DansProjects-24/ArduGauge/README.md

# ArduGauge
This is my Arduino Based Automotive Gauge project, Ardugauge.
Here you'll find any CAD, code, and documentation for the project.  

See more on my website: https://daniel-barker.com/project-browser/ardugauge.html
