DansProjects-24/ArduGauge/Documentation/ArduGauge V1 BOM.xlsx

Sheet: M-Bom
 | Component | Ref | Qty per Assy | Unit Price | Total Price | Print Time [hh:mm]
3D Printed Part | ArduGauge Housing |  | 1 | £0.37 | £0.37 | 1:36:00
 | Spacer Piece |  | 1 | £0.11 | £0.11 | 0:30:00
 | RetainingCollar |  | 1 | £0.31 | £0.31 | 1:20:00
 | RetainingPlate |  | 1 | £0.08 | £0.09 | 0:26:00
Purchased | M2x10 HEX PCB Spacers |  | 8 | £0.44 | £3.52
 | M2x5 Pozi Pan Head Screw |  | 4 | £0.34 | £1.36
 |  |  |  |  | £5.76 | 3:49:00
 | *3D Printed cost & ime includes any waste support material and rafts

Sheet: E-Bom
Component | Ref Name | Value | Package | RS Part Number | Qty | Unit Cost | Notes | Description
ArduGauge V1 PCB |  | - | - | N/A | 1 | £4.990 |  | Manufactured by Aisler. Min order qty 3
1.28" Round LCD |  |  |  | N/A | 1
Multilayer Ceramic Capacitor - 0603 22pF | C1, C2 | 22pF | 0603 (1608) | 8882790 | 2 |  |  | AVX 0603 22pF Ceramic Multilayer Capacitor, 100 V dc, +125C, C0G, NP0 Dielectric, 10%
330μF Electrolytic Capacitor 16V dc, Surface Mount | C3 | 330uF | SMD | 747-2506 | 1 | £0.893 |  | Panasonic 330μF Electrolytic Capacitor 16V dc, Surface Mount - EEEFTC331XAP
 | C4 | 10uF |  |  | 1
100nFMultilayer Ceramic Capacitor 16V, SMD, 0603 (1608M) | C5 | 100nF | 0603 (1608) | 264-4630 | 1 | £0.073 |  | TDK 100nF Multilayer Ceramic Capacitor MLCC 50 V dc 20% X7R Dielectric 1608 Solder Max. Op. Temp. +125C
47μF Electrolytic Tantalum Capacitor 6.3V dc | C6 | 47uF | 3528-21 | 136-6107 | 1 | £0.643 |  | AVX 47μF Electrolytic Tantalum Capacitor 6.3V dc, TPS Series
 | C7, C8 | 10nF |  |  | 2
Inductor 10uH Wire-Wound 1.3A Idc | L1 | 10uH |  | 741-9145 | 1 | £0.590 |  | RS Pro NPIS53D Series Shielded Wire-wound SMD Inductor 10 uH +/-20% Wire-Wound 1.3A Idc
ATMEGA328P-AU, SMD TQFP-32 | IC1 |  | TQFP-32 | 1310271 | 1 | £2.754 |  | MICROCHIP - ATMEGA328P-AU. - MICROCONTROLLER MCU, 8 BIT, ATMEGA, 20MHZ, TQFP-32
JST, PH, 8 Way, 1 Row, Right Angle PCB Header | J1 |  | 8-Pin | 688-1372 | 1 | £1.303 |  | Conn Shrouded Header (4 Sides) HDR 8 POS 2mm Solder RA Side Entry SMD T/R
JST, PH, 8 Way, 1 Row, Straight PCB Header | J2, J3 |  | 8-Pin | 688-1347 | 2 | £1.406 |  | PH SMT top entry shrouded header 8 way JST PH Series, 2mm Pitch 8 Way 1 Row Straight PCB Header, Solder Termination, 2A
CONN_SIL_5 | PL1 | 5-SIL | 5-SIL | - | 1 | £0.500 |  | 5 way Pin Header. 2,54mm Pitch, through hole.
10kΩ, 0805 (2012M) Thick Film SMD Resistor | R1, R9-11 | 10K | 0805 (2012) | - | 4 | £0.300 | *** | 10kΩ, 0805 (2012M) Thick Film SMD Resistor
Vishay 4.7kΩ, 0805 (2012M) Thick Film SMD Resistor ±1% 0.5W | R2, R3 | 4K7 | 0805 (2012) | 812-3574 | 2 | £0.211 | *
5V Low Dropout Voltage Regulator, 1.3A | IC2 | 5V | SOT-223 | 686-9381 | 1 | £0.575 |  | LD1117S50CTR, Low Dropout Voltage Regulator, 1.3A, 5 V 1%, 4-Pin SOT-223
16MHz SMD Crystal, 20ppm, 2-Pin HC-49/U-S SMD | Y1 | 16MHz | 2-Pin SMD | 1734749 | 1 | £0.470 |  | 16.000MHz QCS HC49/U-S SMD Crystal 16MHz, 20ppm, 2-Pin HC-49/U-S SMD
RESISTOR THT | R5-8 | Varies | DISC03 | - | 4 | £0.150 | **
Tactile Switch, (SPST) 50 mA @ 12 V dc 1.5mm Surface Mount | S1 | SPST | SMD | 758-2063 | 1 | £0.742 |  | Tact switch,SMT,SPST,with stem,3.43N o/f Stem Tactile Switch, SPST-NO 50 mA 1.5mm
JST, PH, 8 Way, 1 Row, Cable Mount Connector | - | 8-Way | 8-Pin | 820-1488 | 3 | £0.214
Totals |  |  |  |  |  | £19.209
 |  |  |  |  |  |  | * | Only required when I2C bus is used
 |  |  |  |  |  |  | ** | User selectable. 1 Required per analog channel
 |  |  |  |  |  |  | *** | R9 - 11 only required for V supply monitoring
 |  |  |  |  |  |  |  | Indicative pricing. This may be due to ordering unbranded components or obsolecence of old stock.
