DansProjects-24/ArduGauge/CAD/ArduGauge_Bezel_B.STL

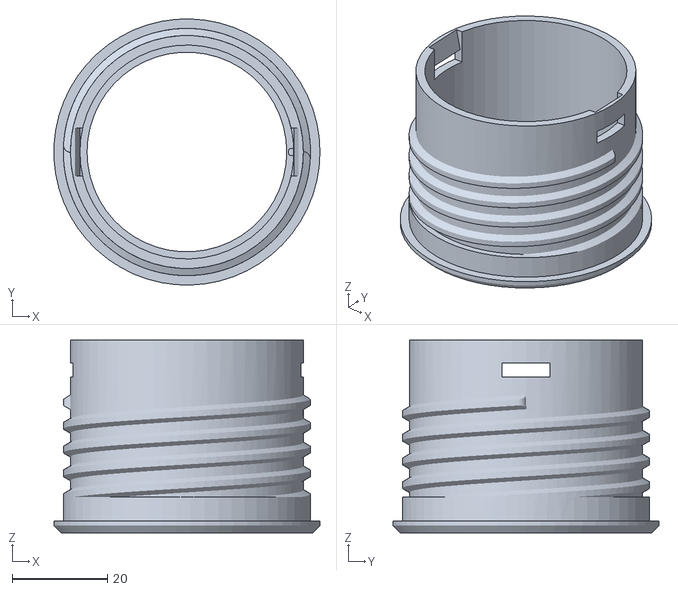
[picture p1: CAD file, 2024-09-01]
CAD/ArduGauge_Bezel_B.STL
56.0 x 56.0 x 40.5
