DansProjects-24/ArduGauge/CAD/RetainingPlate_B.STL

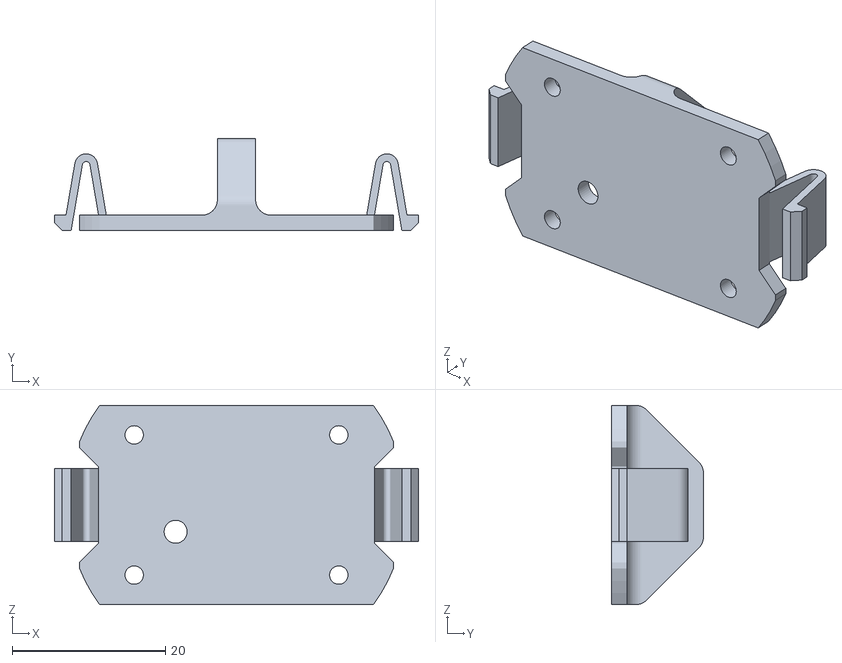
[picture p2: CAD file, 2024-09-01]
CAD/RetainingPlate_B.STL
47.5 x 12.0 x 26.0
