DansProjects-24/ArduGauge/CAD/RetainingCollar_A.STL

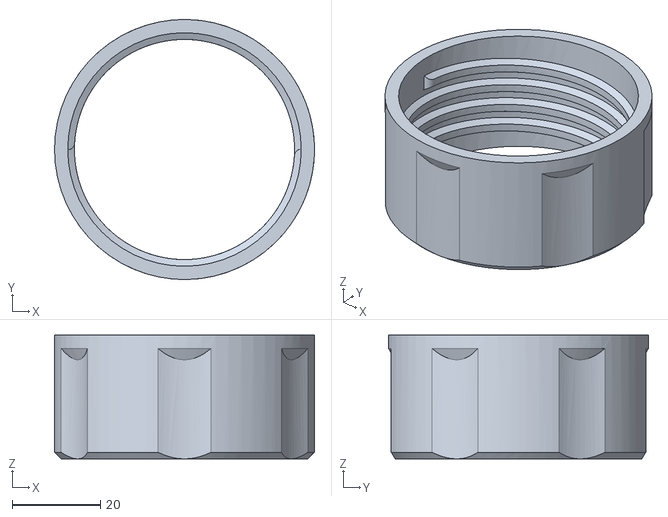
[picture p3: CAD file, 2024-09-01]
CAD/RetainingCollar_A.STL
58.8 x 58.8 x 28.0
