DansProjects-24/ArduGauge/CAD/Spacer_Piece_B.STL

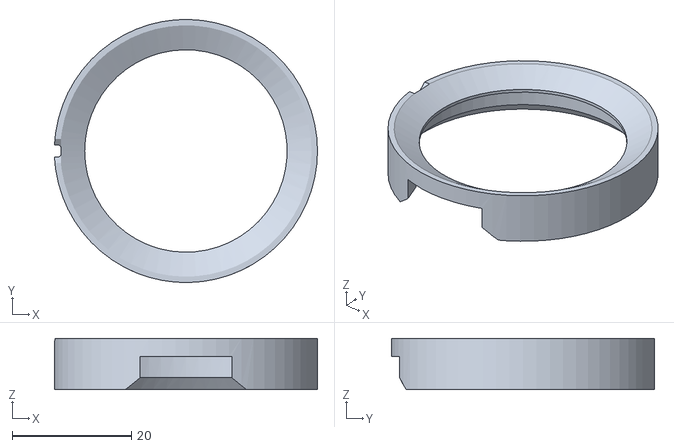
[picture p4: CAD file, 2024-09-01]
CAD/Spacer_Piece_B.STL
44.2 x 44.2 x 8.60
