DansProjects-24/ArduGauge/Schematics & PCB/ArduGauge_V1 - Schematic.pdf

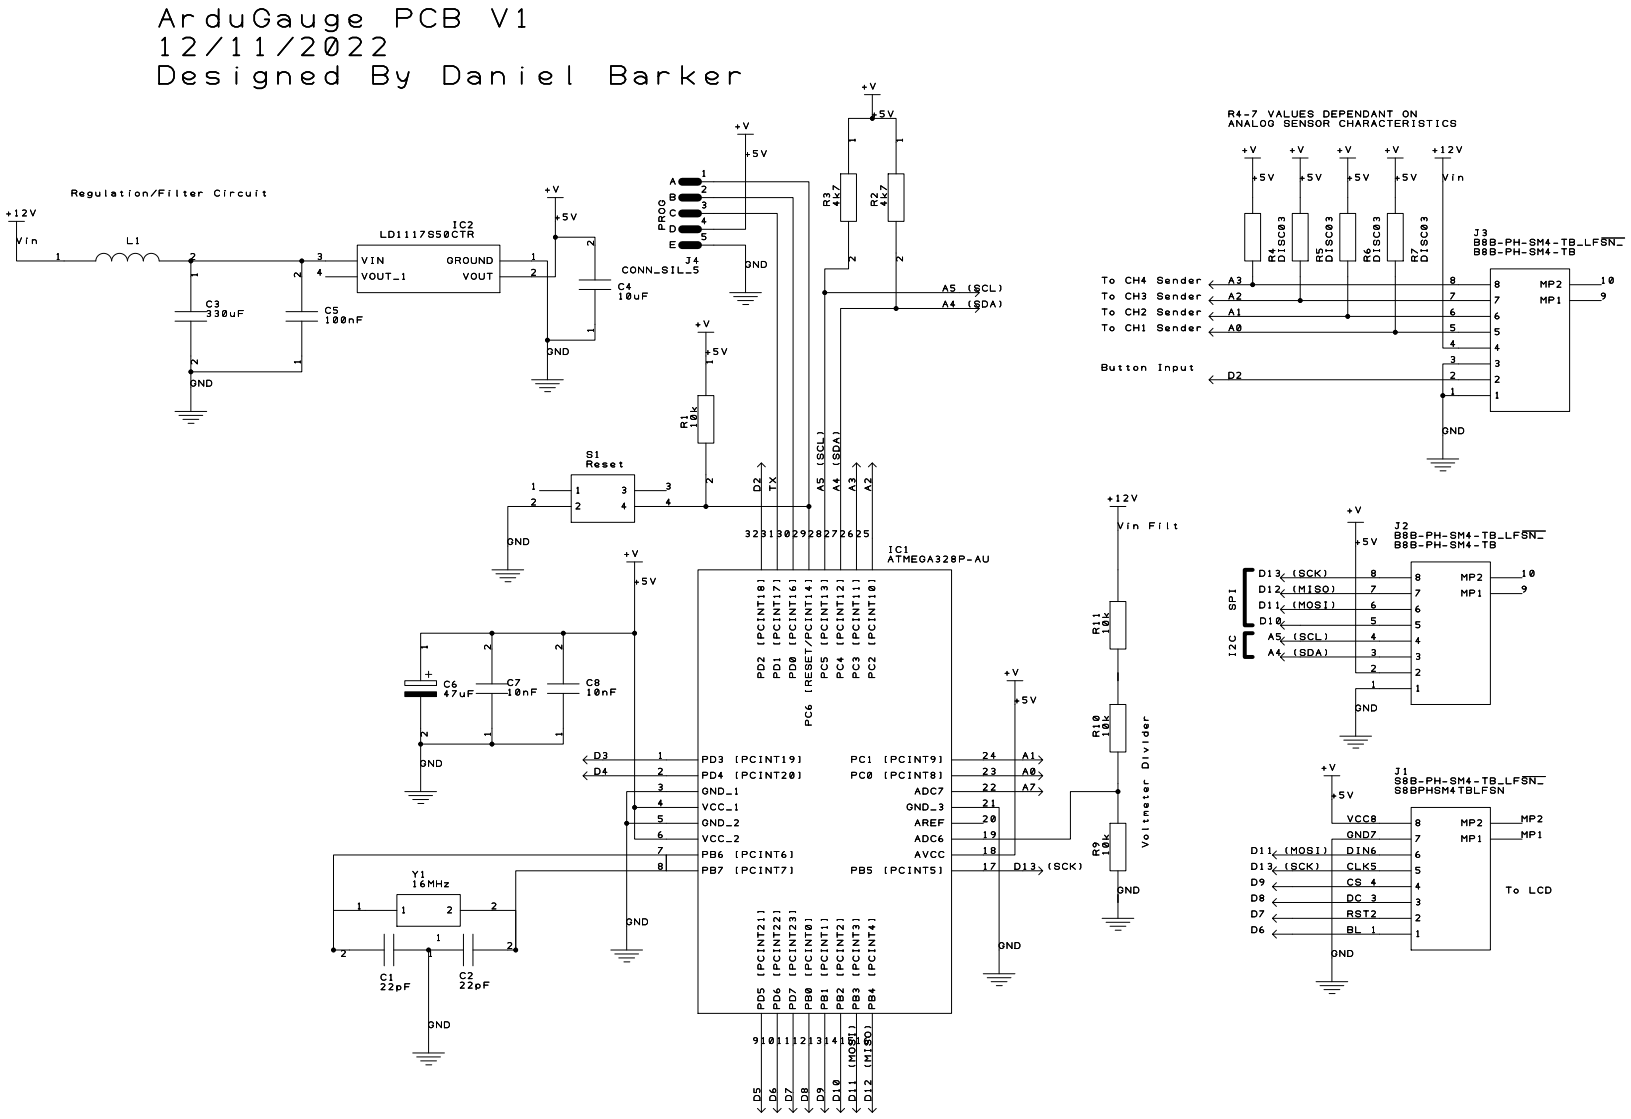
[picture p5: page 1]
