DansProjects-24/ArduGauge/Code/ArduGauge_Dev_2/ArduGauge_Bitmaps.ino

/*
 * This tab contains code for custom bitmapto display temperature symbol.
 * Developed using the 1.28" (240x240px) Round LCD from Waveshare. 
 * Adafruit help: https://learn.adafruit.com/adafruit-gfx-graphics-library/graphics-primitives
 * Image converter: http://javl.github.io/image2cpp/
 */
//Function displays a custom bitmap
// 'Temp Symbol 2', 100x100px

// 'Temp Symbol', 70x70px
const unsigned char epd_bitmap_Temp_Symbol [] PROGMEM = {
  0x00, 0x00, 0x00, 0x00, 0x00, 0x00, 0x00, 0x00, 0x00, 0x00, 0x00, 0x00, 0x00, 0x00, 0x00, 0x00, 
  0x00, 0x00, 0x00, 0x00, 0x00, 0x00, 0x00, 0x00, 0x00, 0x00, 0x00, 0x00, 0x00, 0x00, 0x00, 0x00, 
  0x00, 0x00, 0x00, 0x00, 0x00, 0x00, 0x00, 0x00, 0x00, 0x00, 0x00, 0x00, 0x00, 0x00, 0x00, 0x00, 
  0x00, 0x00, 0x00, 0x00, 0x00, 0x00, 0x00, 0x00, 0x00, 0x00, 0x00, 0x00, 0x00, 0x00, 0x00, 0x00, 
  0x00, 0x00, 0x00, 0x00, 0x00, 0x00, 0x00, 0x00, 0x00, 0x00, 0x00, 0x00, 0x00, 0x00, 0x00, 0x00, 
  0x00, 0x00, 0x00, 0x00, 0x00, 0x00, 0x00, 0x00, 0x00, 0x00, 0x00, 0x00, 0x00, 0x00, 0x30, 0x00, 
  0x00, 0x00, 0x00, 0x00, 0x00, 0x00, 0x00, 0x78, 0x00, 0x00, 0x00, 0x00, 0x00, 0x00, 0x00, 0x00, 
  0xfc, 0x00, 0x00, 0x00, 0x00, 0x00, 0x00, 0x00, 0x00, 0xfc, 0x00, 0x00, 0x00, 0x00, 0x00, 0x00, 
  0x00, 0x00, 0xfc, 0x00, 0x00, 0x00, 0x00, 0x00, 0x00, 0x00, 0x00, 0xfc, 0x00, 0x00, 0x00, 0x00, 
  0x00, 0x00, 0x00, 0x00, 0xfc, 0x00, 0x00, 0x00, 0x00, 0x00, 0x00, 0x00, 0x00, 0xfc, 0x00, 0x00, 
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
  0x00, 0x00, 0x00, 0x00, 0x00, 0x00
};


int printSymbol(int x, int y) 
{
  //drawBitmap(x position, y position, bitmap data, bitmap width, bitmap height, color)
  tft.drawBitmap(x, y, epd_bitmap_Temp_Symbol, 70, 70, GC9A01A_BLUE);
}
